danindudesilva/nbiotdevboard/Board_Bottom.jpg

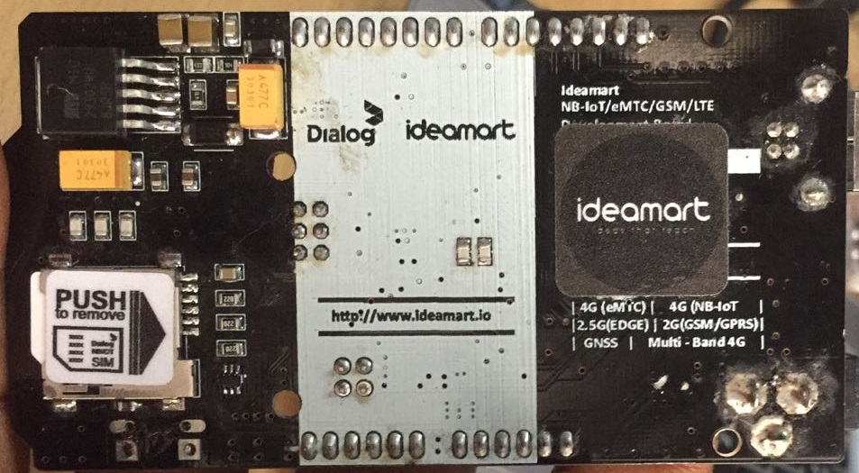
Board_Bottom.jpg
