danindudesilva/nbiotdevboard/README.md

# Ideamart NB-IoT Development Board
Schematics and PCB design files for an Arduino UNO based NB-IoT enabled connected development board
