danindudesilva/nbiotdevboard/bottom.png

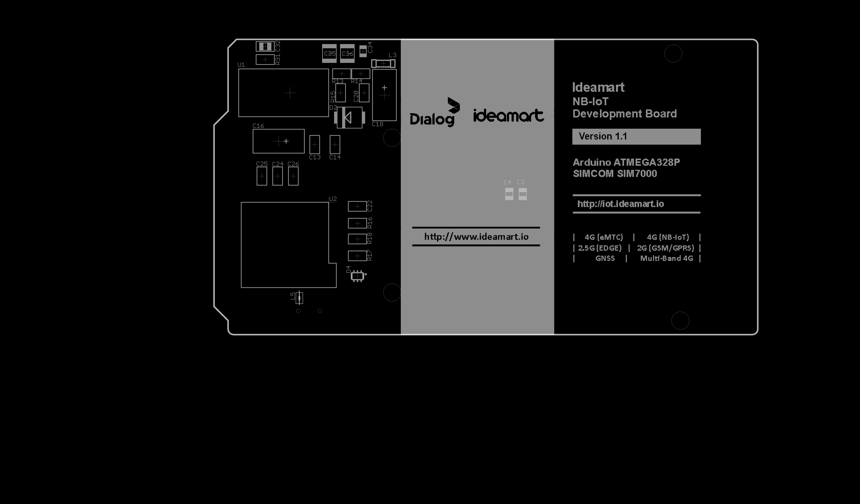
bottom.png
