danindudesilva/nbiotdevboard/top.png

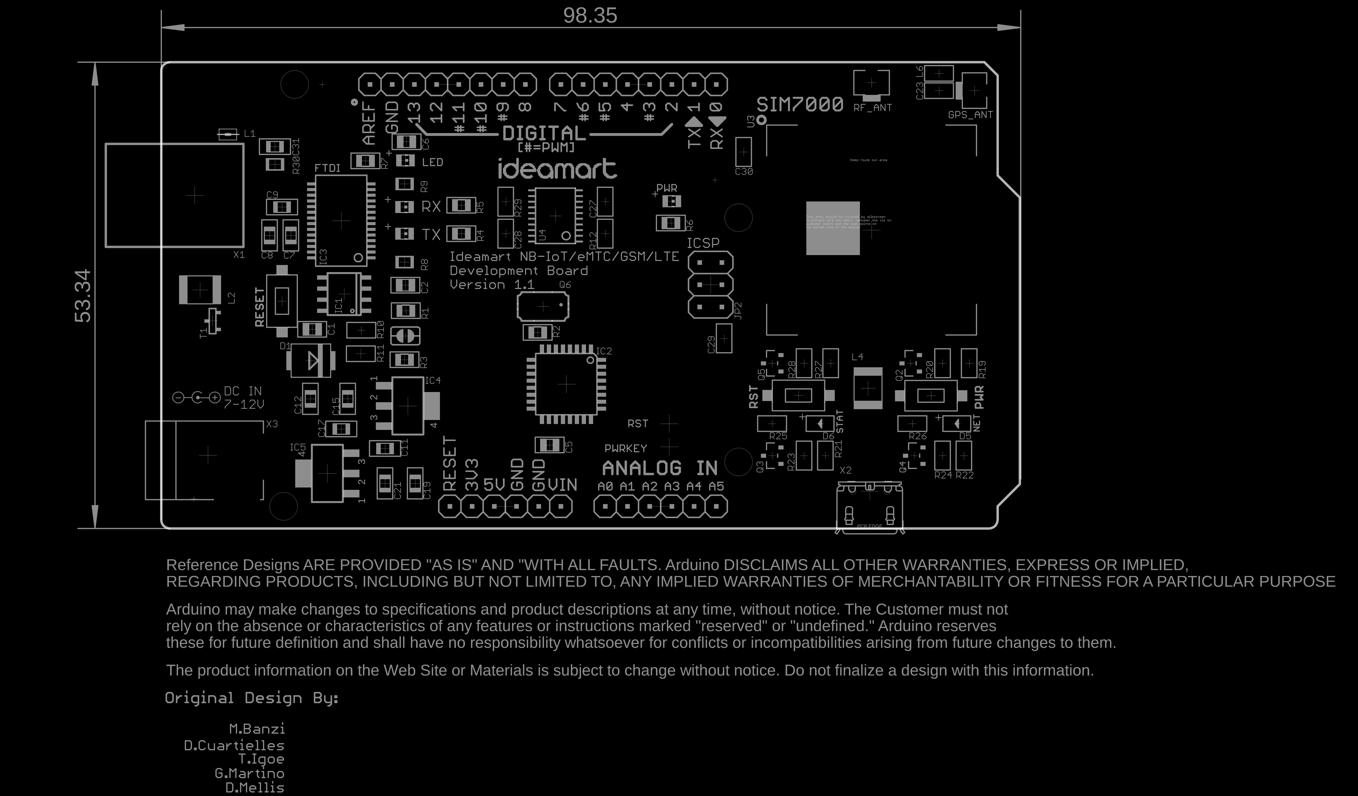
top.png
