danindudesilva/nbiotdevboard/Ideamart NB-IoT Dev Board.pdf

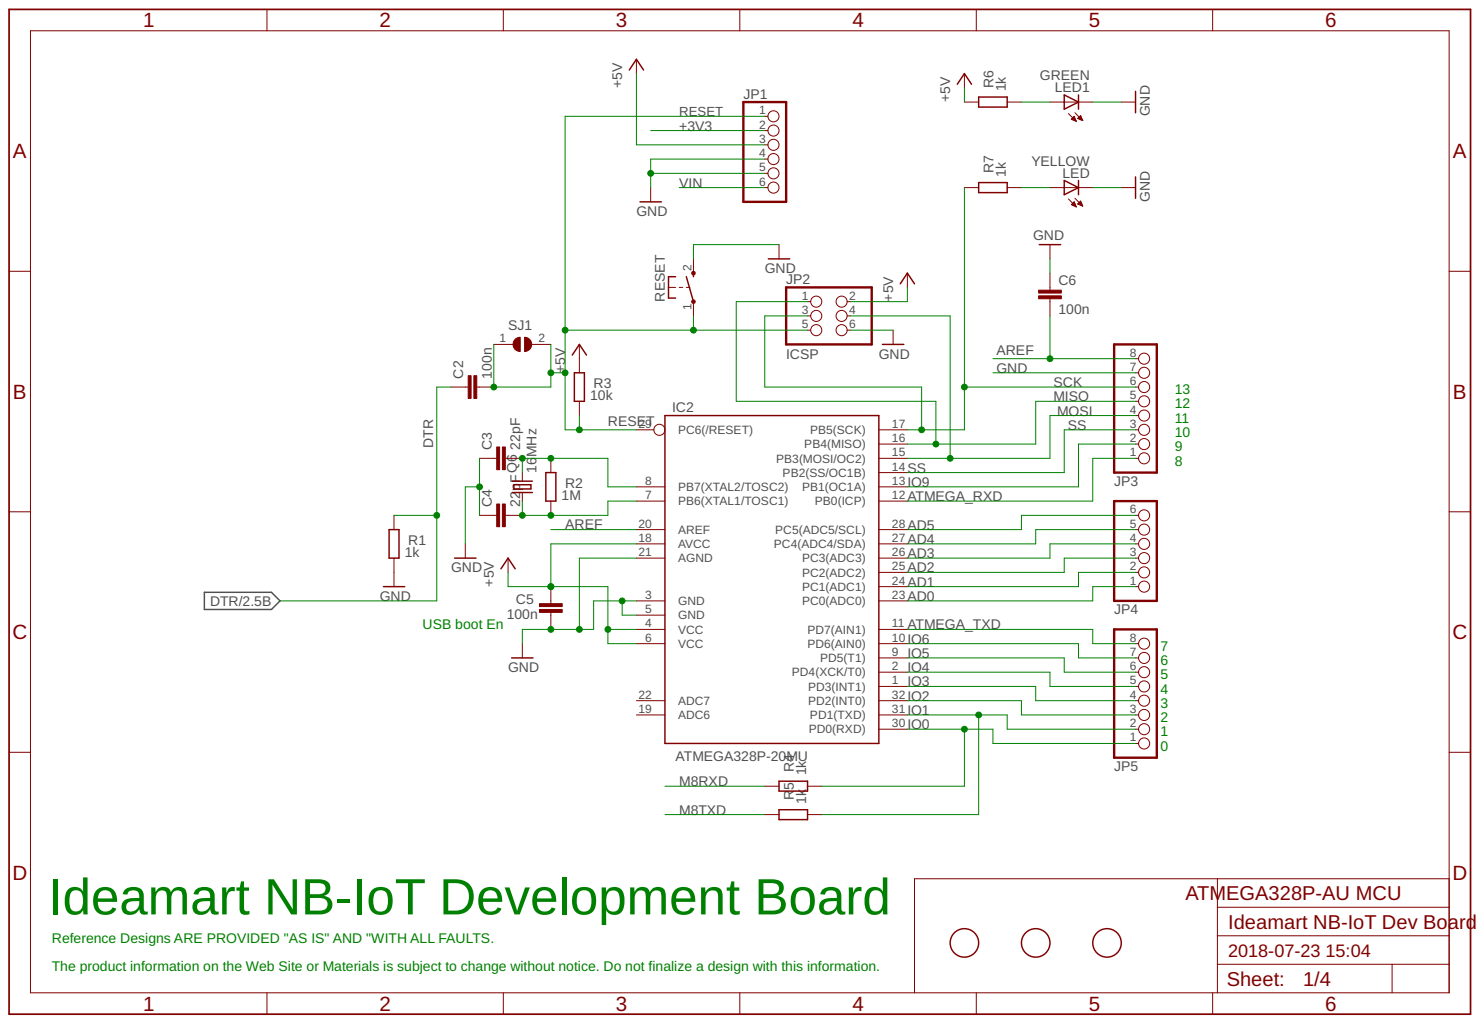
[picture p4: page 1]

IO4 | 6
IO3 | 5
IO2 | 4

Ideamart NB-IoT Development Board

ATMEGA328P-AU MCU
Ideamart NB-IoT Dev Board
Sheet: 1/4

Reference Designs ARE PROVIDED "AS IS" AND "WITH ALL FAULTS. The product information on the Web Site or Materials is subject to change without notice. Do not finalize a design with this information.

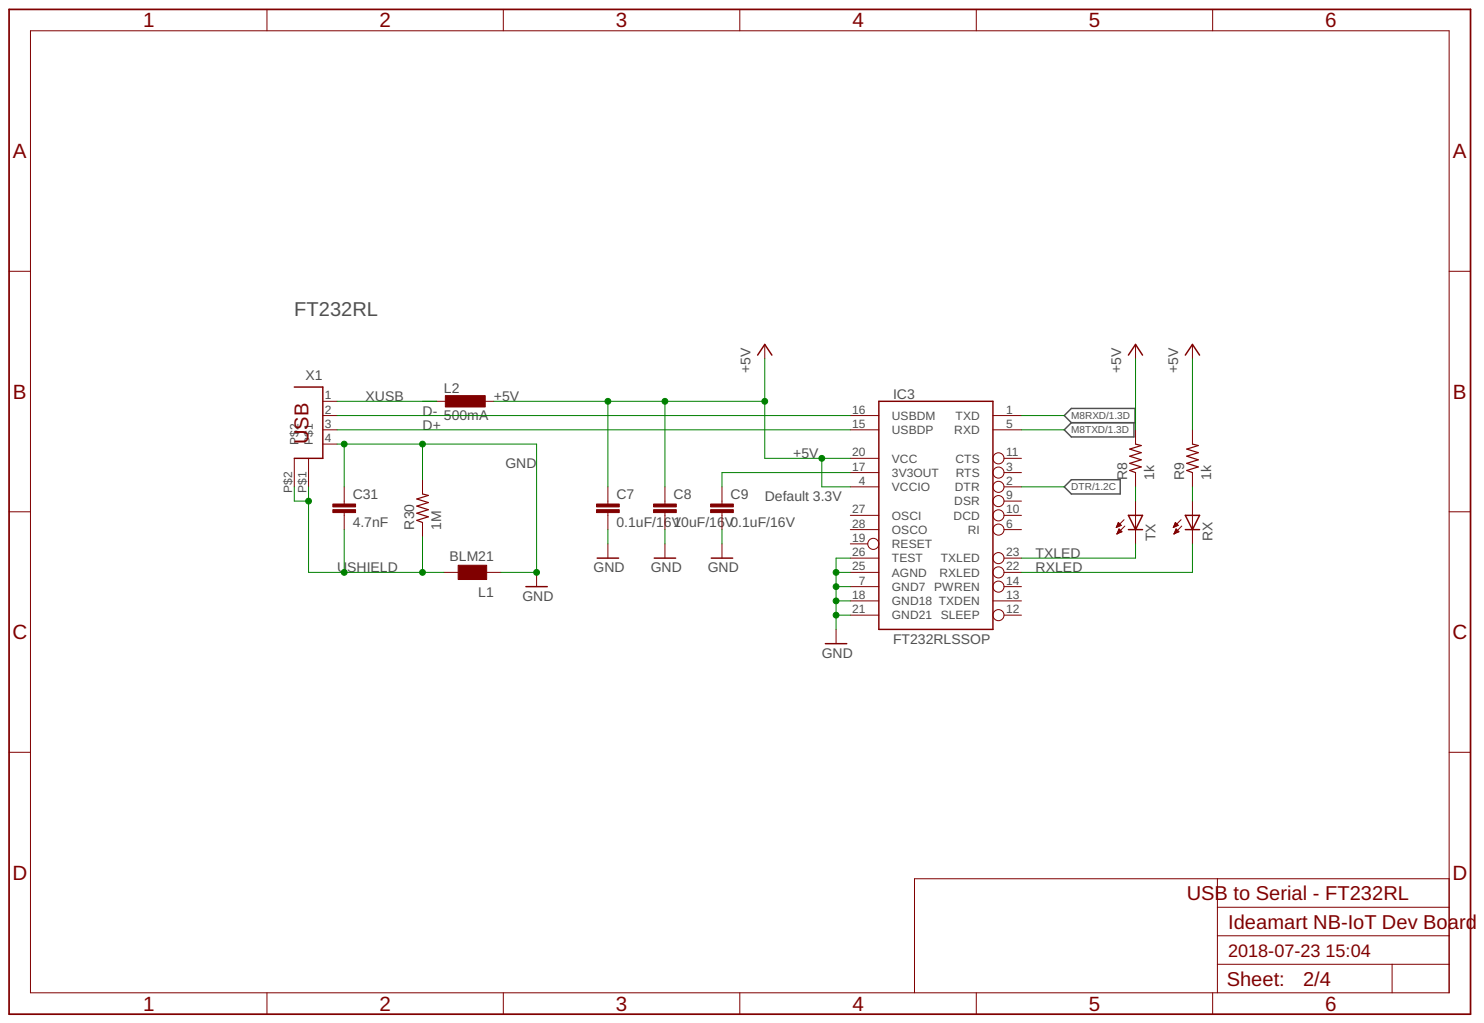
[picture p5: page 2]

USB to Serial - FT232RL
Ideamart NB-IoT Dev Board
Sheet: 2/4

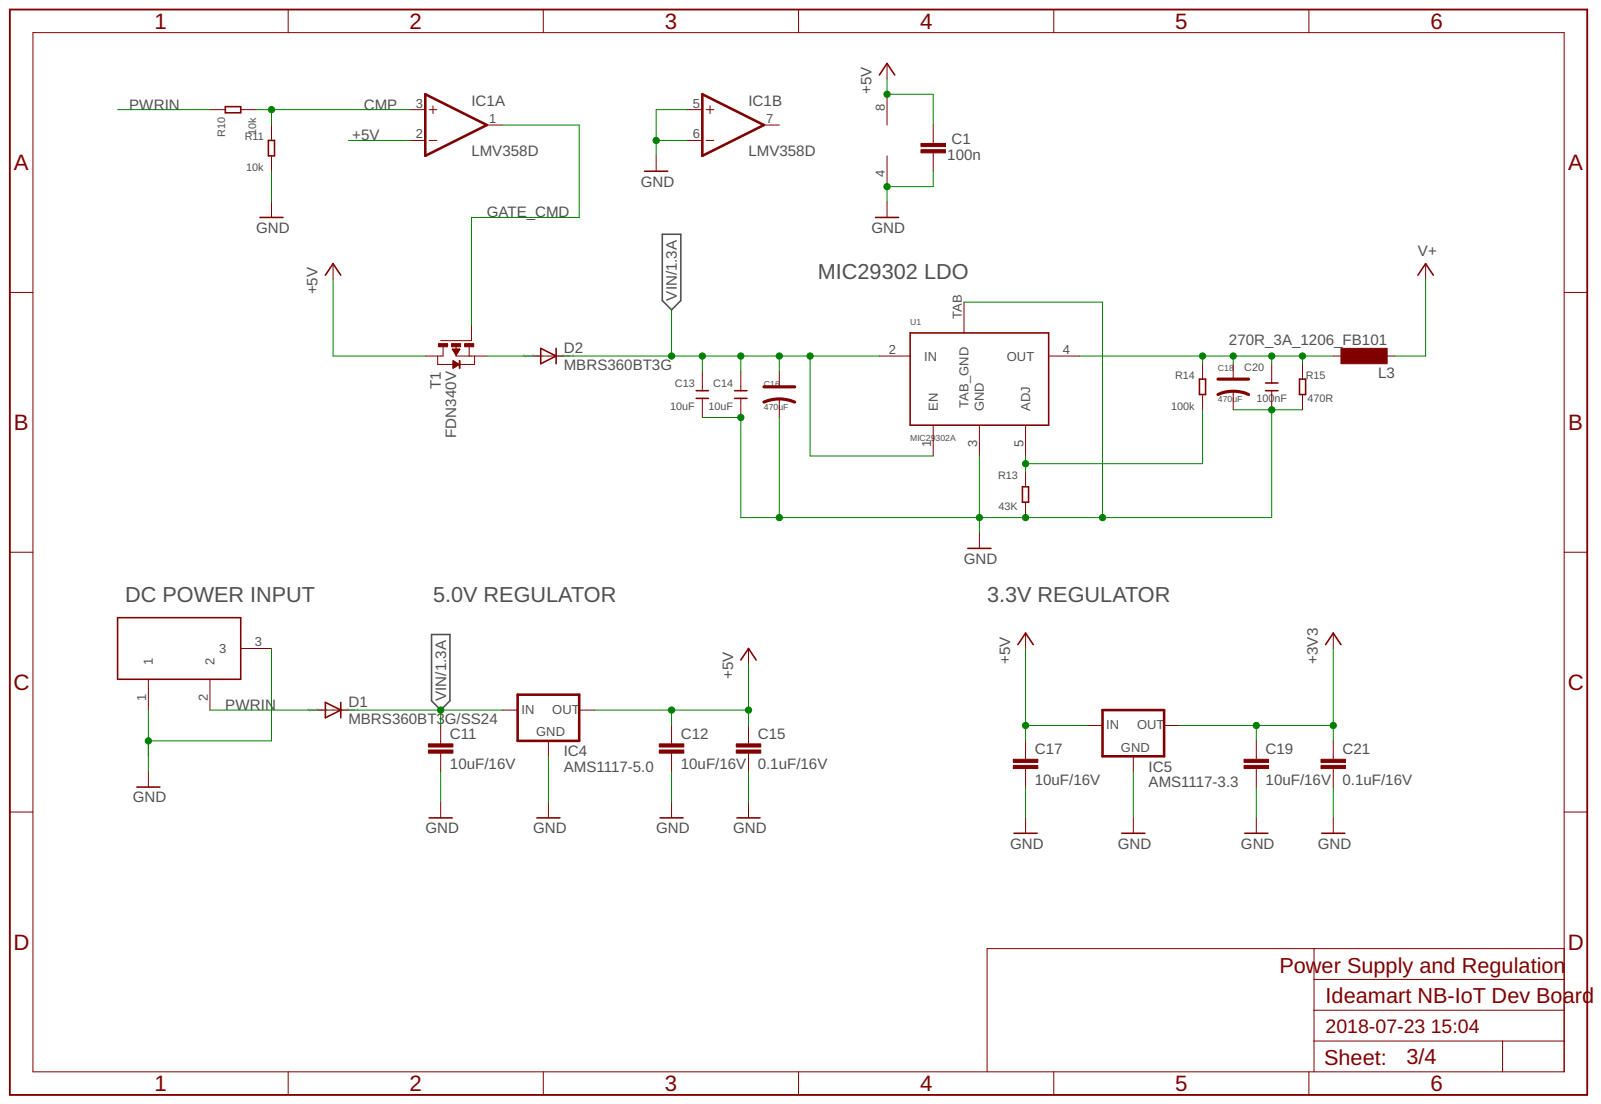
[picture p6: page 3]

Power Supply and Regulation
Ideamart NB-IoT Dev Board
Sheet: 3/4

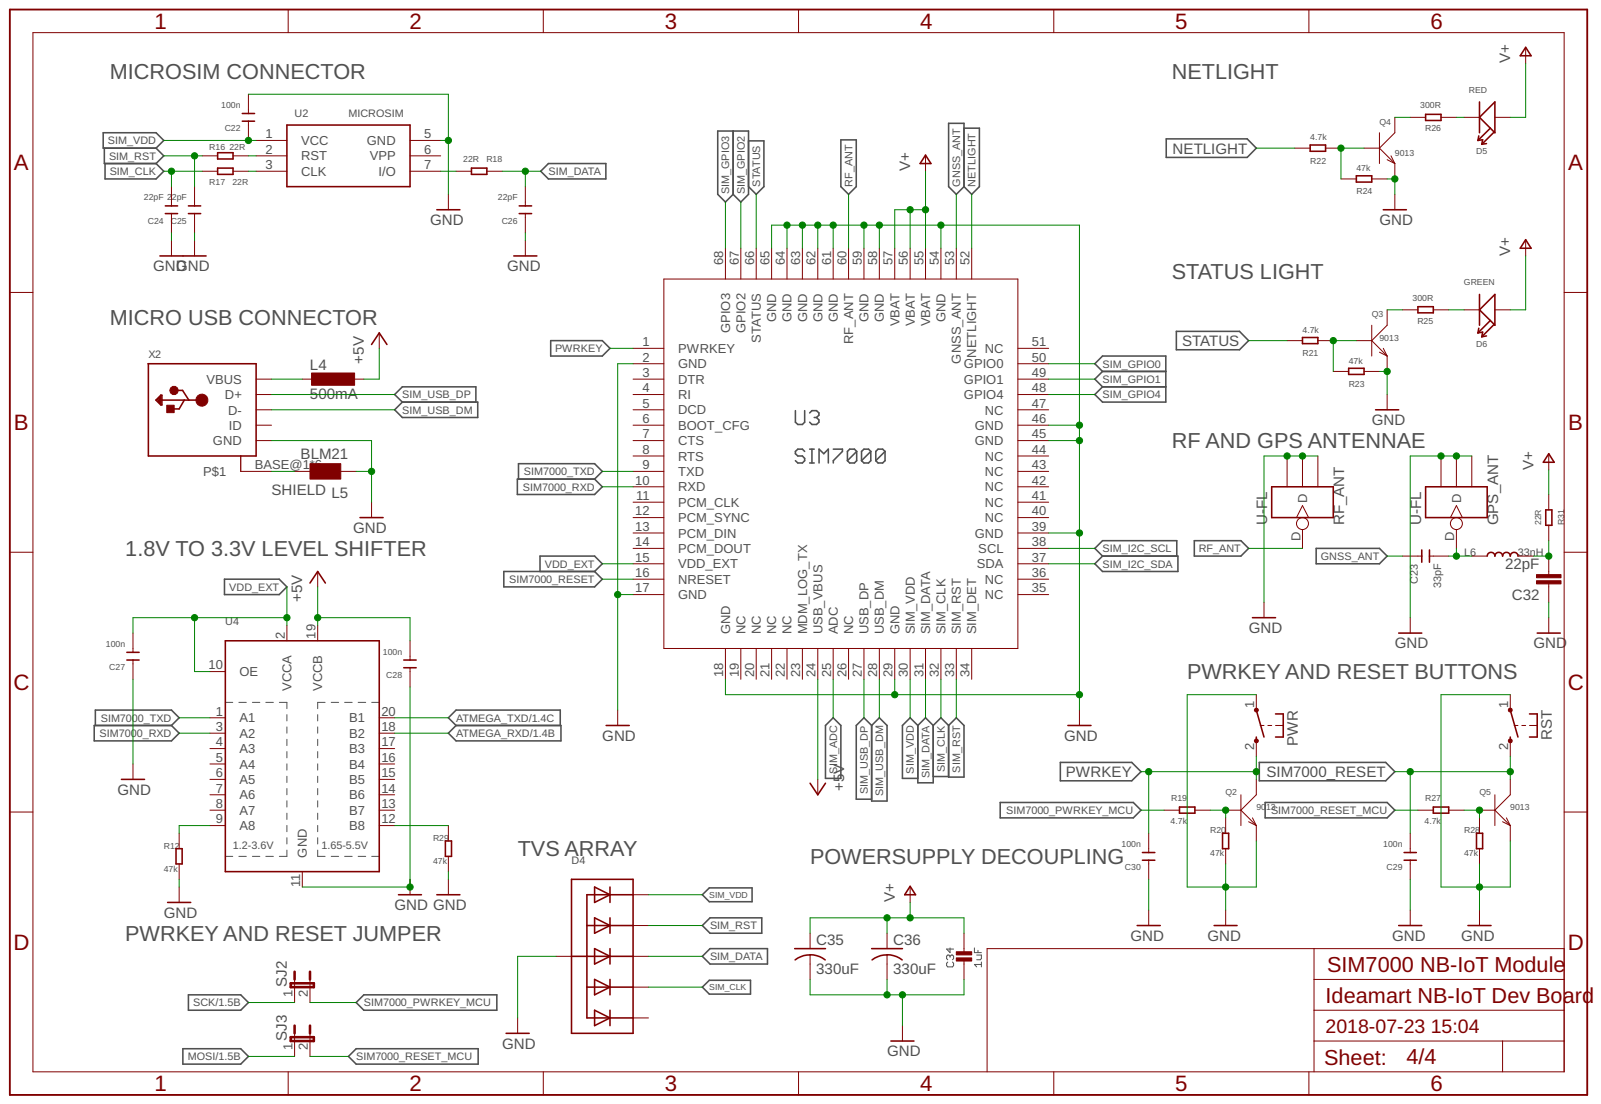
[picture p7: page 4]

RF AND GPS ANTENNAE

PWRKEY AND RESET BUTTONS

PWRKEY AND RESET JUMPER

SIM7000 NB-IoT Module
Ideamart NB-IoT Dev Board
Sheet: 4/4
