danindudesilva/nbiotdevboard/Ideamart_NB-IoT_DevBoard_v1.1.brd

## EAGLE design Ideamart_NB-IoT_DevBoard_v1.1.brd (2020-05-01)

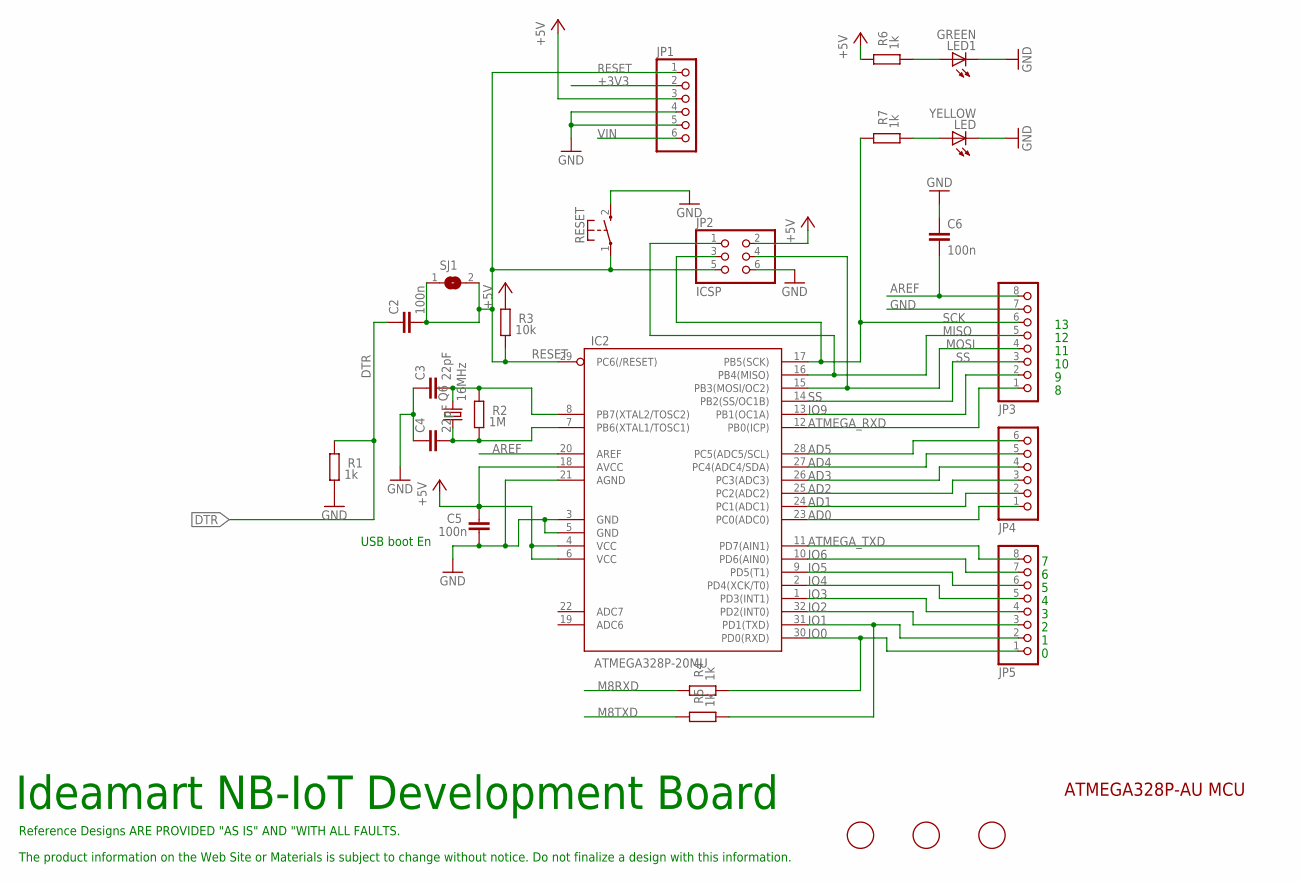
[picture p8: schematic Ideamart_NB-IoT_DevBoard_v1.1.sch, sheet 1]

Parts:
C2, C5, C6: 100n; C0805
C3, C4: 22pF; C0805
IC2: ATMEGA328P-20MU; TQFP32-08
JP1, JP4: PINHD-1X6; 1X06
JP2: ICSP; 2X03
JP3, JP5: PINHD-1X8; 1X08
LED: YELLOW; CHIP-LED0805
LED1: GREEN; CHIP-LED0805
M1, M2, M3: FIDUCIALMOUNT; FIDUCIA-MOUNT
Q6: 16MHz; CTS406
R1, R4, R5, R6, R7: 1k; R0805
R2: 1M; R0805
R3: 10k; R0805
RESET: KSS-2EG4430
SJ1: SJ

Connections:
+3V3: JP1.2; also elsewhere on the board
+5V: C5.2, IC2.4 (VCC), IC2.6 (VCC), IC2.18 (AVCC), JP1.3, JP2.2, R3.2, R6.2; also elsewhere on the board
AD0: IC2.23 (PC0(ADC0)), JP4.1
AD1: IC2.24 (PC1(ADC1)), JP4.2
AD2: IC2.25 (PC2(ADC2)), JP4.3
AD3: IC2.26 (PC3(ADC3)), JP4.4
AD4: IC2.27 (PC4(ADC4/SDA)), JP4.5
AD5: IC2.28 (PC5(ADC5/SCL)), JP4.6
AREF: C6.2, IC2.20 (AREF), JP3.8
ATMEGA_RXD: IC2.12 (PB0(ICP)), JP3.1; also elsewhere on the board
ATMEGA_TXD: IC2.11 (PD7(AIN1)), JP5.8; also elsewhere on the board
DTR: C2.1, R1.2; also elsewhere on the board
GND: C3.1, C4.1, C5.1, C6.1, IC2.3 (GND), IC2.5 (GND), IC2.21 (AGND), JP1.4, JP1.5, JP2.6, JP3.7, LED.C, LED1.C, R1.1, RESET.2 (S); also elsewhere on the board
IO0: IC2.30 (PD0(RXD)), JP5.1, R4.1
IO1: IC2.31 (PD1(TXD)), JP5.2, R5.1
IO2: IC2.32 (PD2(INT0)), JP5.3
IO3: IC2.1 (PD3(INT1)), JP5.4
IO4: IC2.2 (PD4(XCK/T0)), JP5.5
IO5: IC2.9 (PD5(T1)), JP5.6
IO6: IC2.10 (PD6(AIN0)), JP5.7
IO9: IC2.13 (PB1(OC1A)), JP3.2
M8RXD: R4.2; also elsewhere on the board
M8TXD: R5.2; also elsewhere on the board
MISO: IC2.16 (PB4(MISO)), JP2.1, JP3.5
MOSI: IC2.15 (PB3(MOSI/OC2)), JP2.4, JP3.4; also elsewhere on the board
unnamed: LED.A, R7.1
unnamed: LED1.A, R6.1
RESET: C2.2, IC2.29 (PC6(/RESET)), JP1.1, JP2.5, R3.1, RESET.1, SJ1.1, SJ1.2
SCK: IC2.17 (PB5(SCK)), JP2.3, JP3.6, R7.2; also elsewhere on the board
SS: IC2.14 (PB2(SS/OC1B)), JP3.3
VIN: JP1.6; also elsewhere on the board
XTAL1: C4.2, IC2.7 (PB6(XTAL1/TOSC1)), Q6.1, R2.1
XTAL2: C3.2, IC2.8 (PB7(XTAL2/TOSC2)), Q6.3 (2), R2.2

Notes on the sheet:
Ideamart NB-IoT Development Board
USB boot En
Reference Designs ARE PROVIDED "AS IS" AND "WITH ALL FAULTS.
The product information on the Web Site or Materials is subject to change without notice. Do not finalize a design with this information.
ATMEGA328P-AU MCU

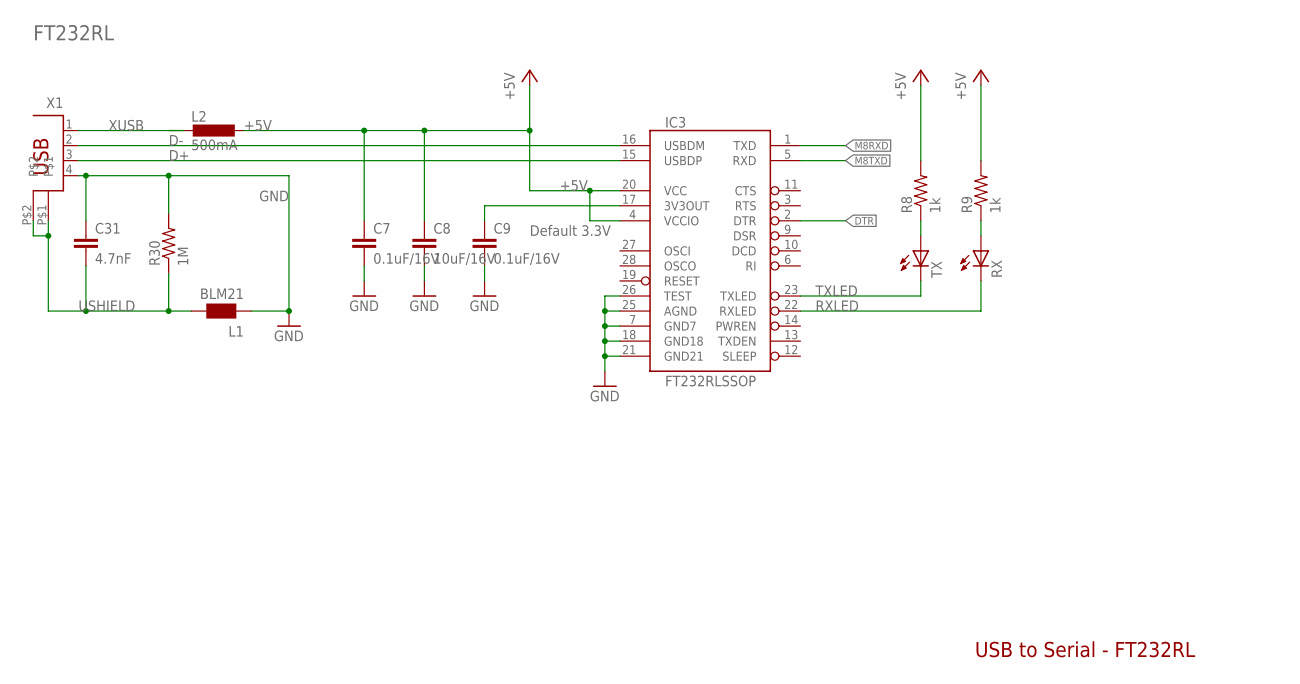
[picture p9: schematic Ideamart_NB-IoT_DevBoard_v1.1.sch, sheet 2]

Parts:
C7, C9: 0.1uF/16V; C0805K
C8: 10uF/16V; C0805K
C31: 4.7nF; C0805K
IC3: FT232RLSSOP; SSOP28DB
L1: BLM21; 0805
L2: 500mA; L1812
R8, R9: 1k; M0805
R30: 1M; M0805
RX: LEDCHIP-LED0805; CHIP-LED0805
TX: LEDCHIP-LED0805; CHIP-LED0805
X1: PN61729

Connections:
+5V: C7.1, C8.1, IC3.4 (VCCIO), IC3.20 (VCC), L2.1, R8.2, R9.2; also elsewhere on the board
D+: IC3.15 (USBDP), X1.3
D-: IC3.16 (USBDM), X1.2
DTR: IC3.2 (DTR); also elsewhere on the board
GND: C7.2, C8.2, C9.2, C31.1, IC3.7 (GND7), IC3.18 (GND18), IC3.21 (GND21), IC3.25 (AGND), IC3.26 (TEST), L1.1, R30.2, X1.4; also elsewhere on the board
M8RXD: IC3.1 (TXD); also elsewhere on the board
M8TXD: IC3.5 (RXD); also elsewhere on the board
unnamed: C9.1, IC3.17 (3V3OUT)
unnamed: R8.1, TX.A
unnamed: R9.1, RX.A
RXLED: IC3.22 (RXLED), RX.C
TXLED: IC3.23 (TXLED), TX.C
USHIELD: C31.2, L1.2, R30.1, X1.P$1, X1.P$2
XUSB: L2.2, X1.1

Notes on the sheet:
Default 3.3V
USB to Serial - FT232RL
FT232RL

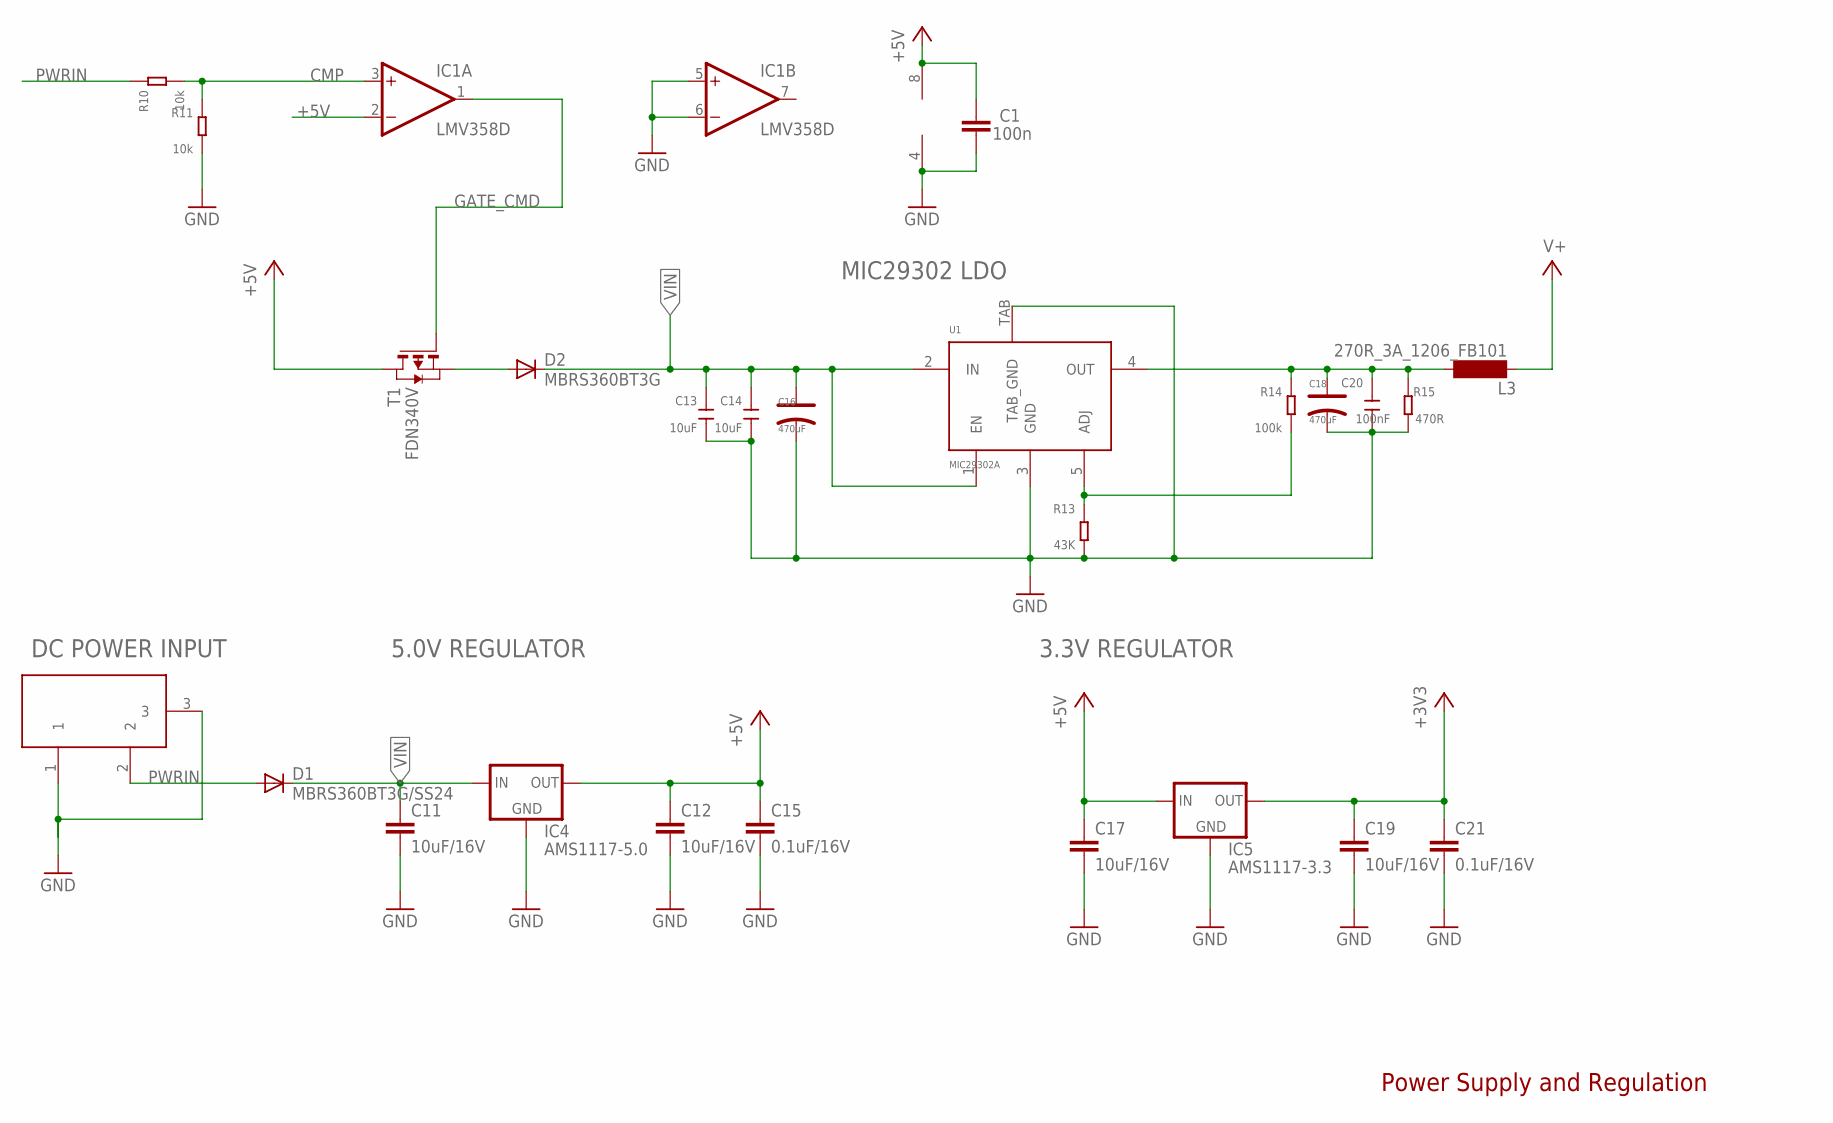
[picture p10: schematic Ideamart_NB-IoT_DevBoard_v1.1.sch, sheet 3]

Parts:
C1: 100n; C0805
C11, C12, C17, C19: 10uF/16V; C0805K
C13, C14: 10uF; 0805
C15, C21: 0.1uF/16V; C0805K
C16, C18: 470uF; AVX_D
C20: 100nF; 0805
D1: MBRS360BT3G/SS24; SMB
D2: MBRS360BT3G; SMB
IC1: LMV358D; SO08
IC4: AMS1117-5.0; SOT223
IC5: AMS1117-3.3; SOT223
L3: 270R_3A_1206_FB101; SM-1206
R10, R11: 10k; 0805
R13: 43K; 0805
R14: 100k; 0805
R15: 470R; 0805
T1: FDN340V; SOT-23
U1: MIC29302A; TO-263A
X3: DC21MMX; DC-21MM

Connections:
+3V3: C19.1, C21.1, IC5.2 (OUT); also elsewhere on the board
+5V: C1.2, C12.1, C15.1, C17.1, IC1.2 (-IN), IC1.8 (V+), IC4.2 (OUT), IC5.3 (IN), T1.1 (D); also elsewhere on the board
CMP: IC1.3 (+IN), R10.1, R11.2
GATE_CMD: IC1.1 (OUT), T1.3 (G)
GND: C1.1, C11.2, C12.2, C13.1, C14.1, C15.2, C16.-, C17.2, C18.-, C19.2, C20.1, C21.2, IC1.4 (V-), IC1.5 (+IN), IC1.6 (-IN), IC4.1 (GND), IC5.1 (GND), R11.1, R13.1, R15.1, U1.3 (GND), U1.TAB (TAB_GND), X3.1, X3.3; also elsewhere on the board
unnamed: R13.2, R14.1, U1.5 (ADJ)
unnamed: D2.A, T1.2 (S)
PWRIN: D1.A, R10.2, X3.2
V+: L3.1; also elsewhere on the board
VIN: C11.1, C13.2, C14.2, C16.+, D1.C, D2.C, IC4.3 (IN), U1.1 (EN), U1.2 (IN); also elsewhere on the board
VOUT: C18.+, C20.2, L3.2, R14.2, R15.2, U1.4 (OUT)

Notes on the sheet:
DC POWER INPUT
Power Supply and Regulation
3.3V REGULATOR
MIC29302 LDO
5.0V REGULATOR

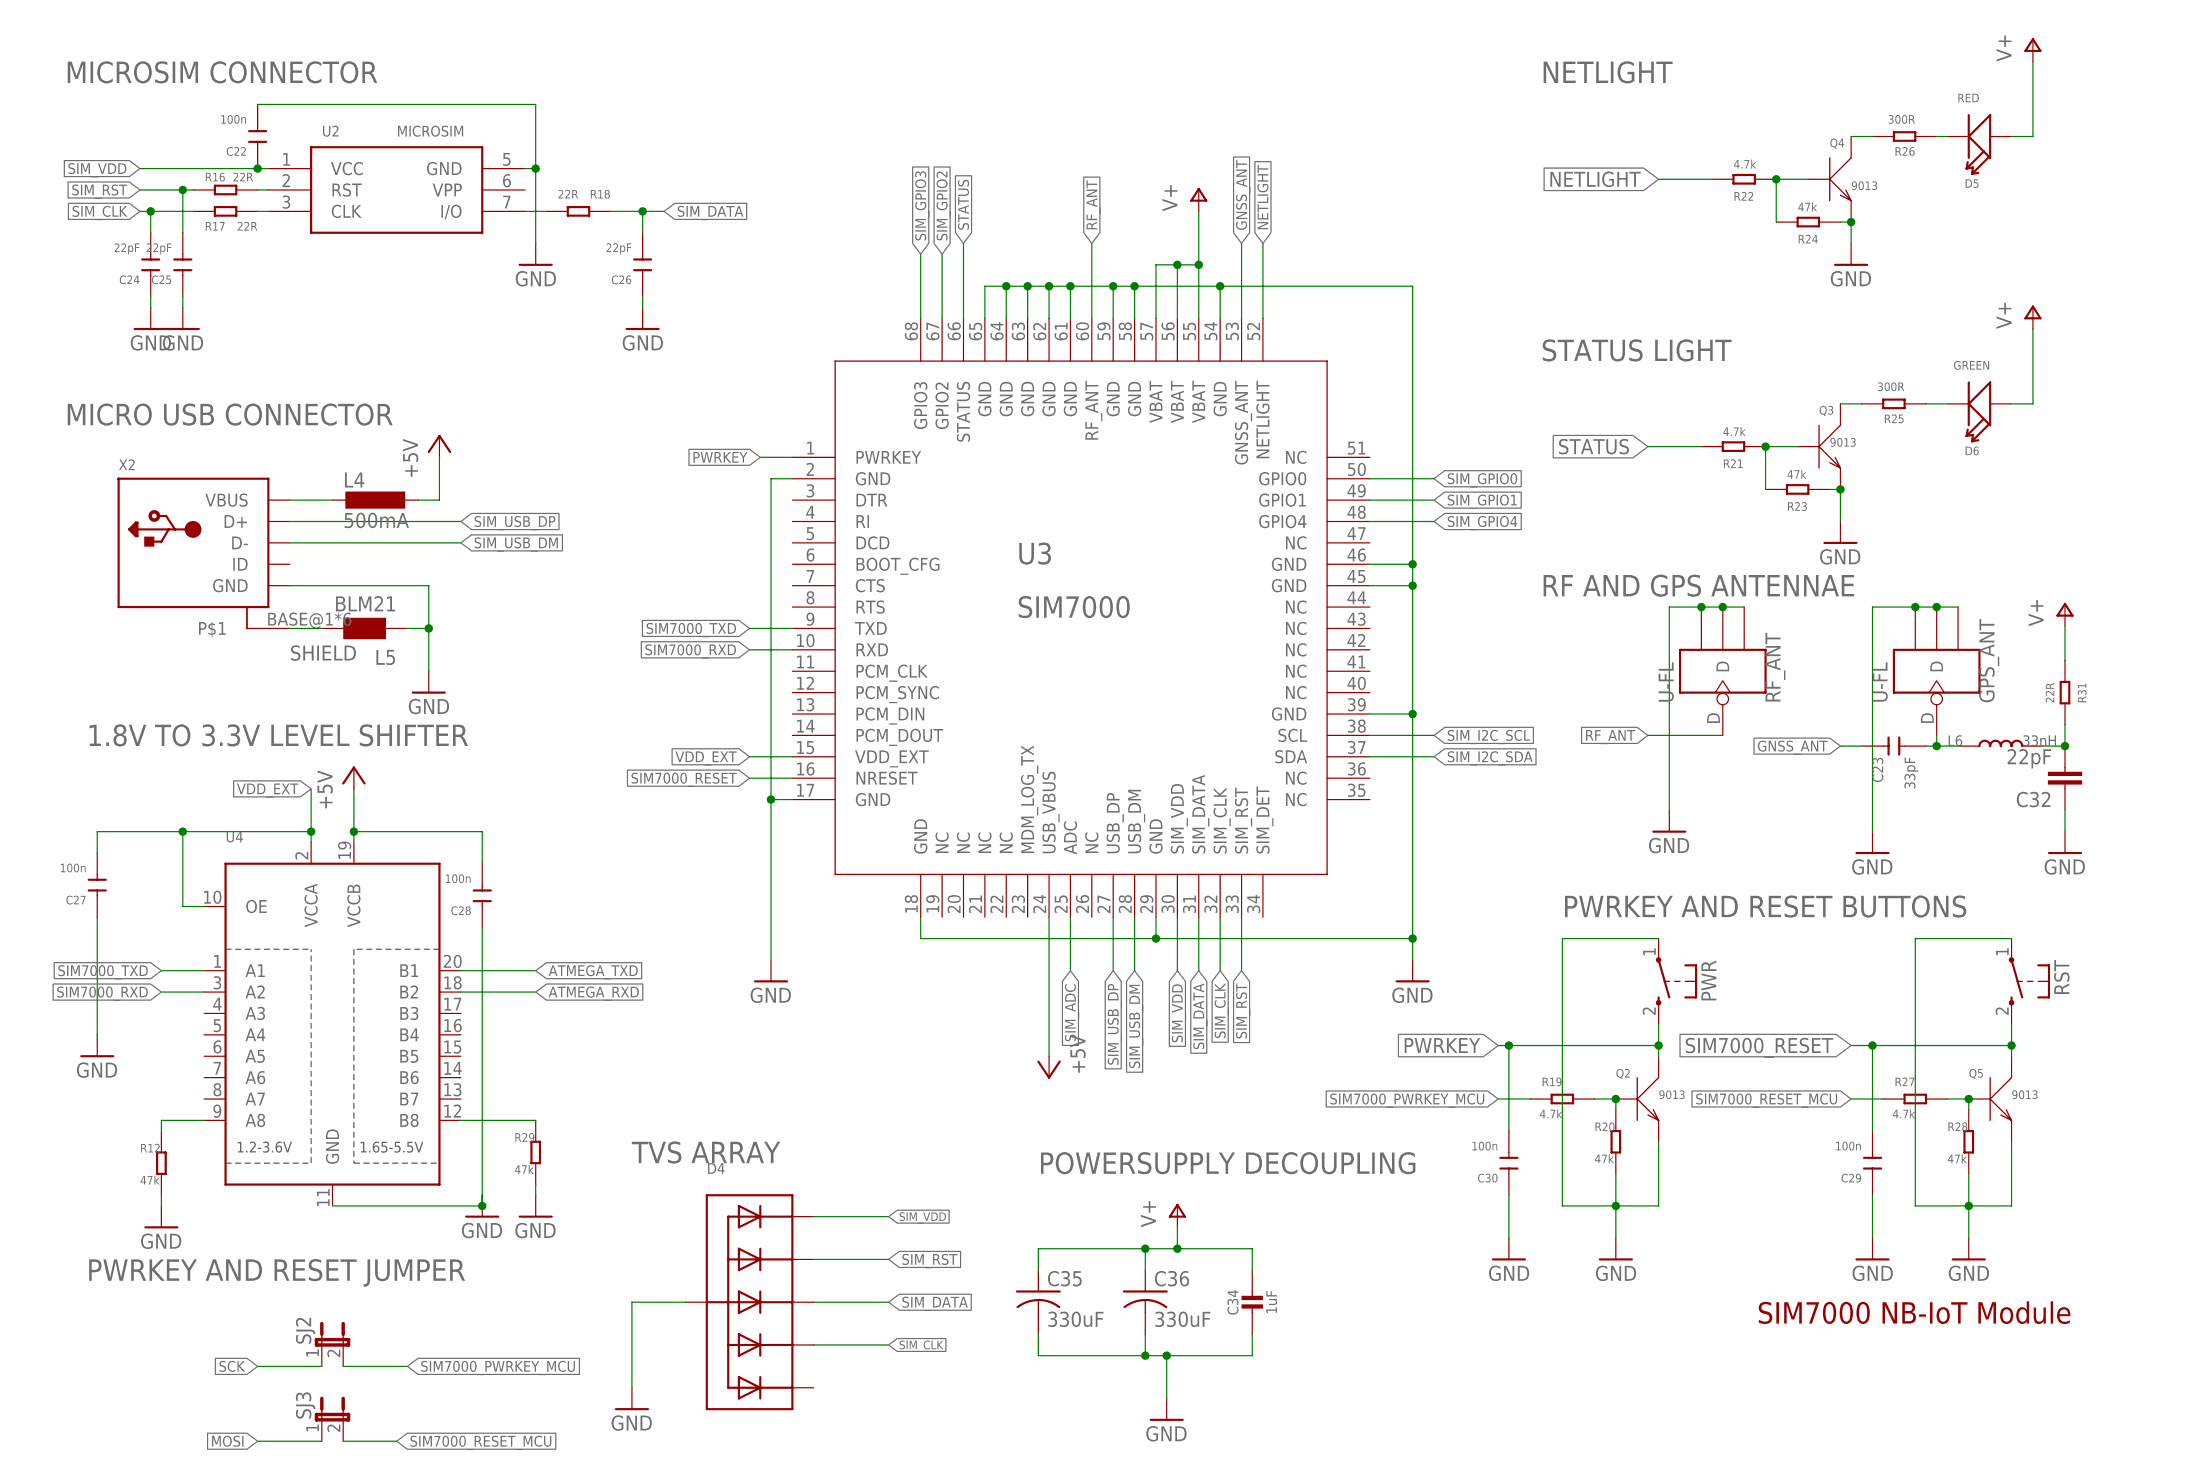
[picture p11: schematic Ideamart_NB-IoT_DevBoard_v1.1.sch, sheet 4]

Parts:
C22, C27, C28, C29, C30: 100n; 0805
C23: 33pF; 0805
C24, C25, C26: 22pF; 0805
C32: 22pF; C0805
C34: 1uF; _0805
C35, C36: 330uF; C1210
D4: TVSARRAY_5LANE; SOT363
D5: RED; LED-0805
D6: GREEN; LED-0805
GPS_ANT: U-FL; 4P-U-FL
L4: 500mA; L1812
L5: BLM21; 0805
L6: 33nH; L0805
PWR: KSS-2EG4430
Q2, Q3, Q4, Q5: 9013; SOT23
R12, R20, R23, R24, R28, R29: 47k; 0805
R16, R17, R18, R31: 22R; 0805
R19, R21, R22, R27: 4.7k; 0805
R25, R26: 300R; 0805
RF_ANT: U-FL; 4P-U-FL
RST: KSS-2EG4430
SJ2, SJ3: SPARKFUN-PASSIVES_JUMPER-PTH-2-NC; SPARKFUN-PASSIVES_PTH-JUMPER-NC_BOTTOM_NO_SILK
U2: MICROSIM
U3: SIM7000
U4: TXB0108PWR; TSSOP20
X2: USB_MICRO_20329_V2; 4UCONN_20329_V2

Connections:
+5V: C28.2, L4.1, U3.24 (USB_VBUS), U4.19 (VCCB); also elsewhere on the board
ATMEGA_RXD: U4.18 (B2); also elsewhere on the board
ATMEGA_TXD: U4.20 (B1); also elsewhere on the board
GND: C22.2, C24.1, C25.1, C26.1, C27.1, C28.1, C29.1, C30.1, C32.1, C34.2, C35.2, C36.2, D4.2 (A), GPS_ANT.GND1, GPS_ANT.GND2, GPS_ANT.GND3, L5.1, PWR.1, Q2.2 (E), Q3.2 (E), Q4.2 (E), Q5.2 (E), R12.2, R20.2, R23.2, R24.2, R28.2, R29.2, RF_ANT.GND1, RF_ANT.GND2, RF_ANT.GND3, RST.1, U2.5 (GND), U3.2 (GND), U3.17 (GND), U3.18 (GND), U3.29 (GND), U3.39 (GND), U3.45 (GND), U3.46 (GND), U3.54 (GND), U3.58 (GND), U3.59 (GND), U3.61 (GND), U3.62 (GND), U3.63 (GND), U3.64 (GND), U3.65 (GND), U4.11 (GND), X2.GND; also elsewhere on the board
GNSS_ANT: C23.2, U3.53 (GNSS_ANT)
MOSI: SJ3.1; also elsewhere on the board
unnamed: Q3.3 (C), R25.2
unnamed: D6.-, R25.1
unnamed: Q3.1 (B), R21.2, R23.1
unnamed: R18.2, U2.7 (I/O)
unnamed: R17.1, U2.3 (CLK)
unnamed: R16.1, U2.2 (RST)
unnamed: Q5.1 (B), R27.2, R28.1
unnamed: L4.2, X2.VBUS
unnamed: Q4.3 (C), R26.2
unnamed: D5.-, R26.1
unnamed: Q4.1 (B), R22.2, R24.1
unnamed: C23.1, GPS_ANT.D, L6.1
unnamed: R12.1, U4.9 (A8)
unnamed: R29.1, U4.12 (B8)
unnamed: C32.2, L6.2, R31.1
unnamed: Q2.1 (B), R19.2, R20.1
NETLIGHT: R22.1, U3.52 (NETLIGHT)
PWRKEY: C30.2, PWR.2 (S), Q2.3 (C), U3.1 (PWRKEY)
RF_ANT: RF_ANT.D, U3.60 (RF_ANT)
SCK: SJ2.1; also elsewhere on the board
SHIELD: L5.2, X2.BASE@1, X2.BASE@2, X2.SPRT@1, X2.SPRT@2, X2.SPRT@3, X2.SPRT@4
SIM7000_PWRKEY_MCU: R19.1, SJ2.2
SIM7000_RESET: C29.2, Q5.3 (C), RST.2 (S), U3.16 (NRESET)
SIM7000_RESET_MCU: R27.1, SJ3.2
SIM7000_RXD: U3.10 (RXD), U4.3 (A2)
SIM7000_TXD: U3.9 (TXD), U4.1 (A1)
SIM_ADC: U3.25 (ADC)
SIM_CLK: C24.2, D4.5 (C4), R17.2, U3.32 (SIM_CLK)
SIM_DATA: C26.2, D4.4 (C3), R18.1, U3.31 (SIM_DATA)
SIM_GPIO0: U3.50 (GPIO0)
SIM_GPIO1: U3.49 (GPIO1)
SIM_GPIO2: U3.67 (GPIO2)
SIM_GPIO3: U3.68 (GPIO3)
SIM_GPIO4: U3.48 (GPIO4)
SIM_I2C_SCL: U3.38 (SCL)
SIM_I2C_SDA: U3.37 (SDA)
SIM_RST: C25.2, D4.3 (C2), R16.2, U3.33 (SIM_RST)
SIM_USB_DM: U3.28 (USB_DM), X2.D-
SIM_USB_DP: U3.27 (USB_DP), X2.D+
SIM_VDD: C22.1, D4.1 (C1), U2.1 (VCC), U3.30 (SIM_VDD)
STATUS: R21.1, U3.66 (STATUS)
V+: C34.1, C35.1, C36.1, D5.+, D6.+, R31.2, U3.55 (VBAT), U3.56 (VBAT), U3.57 (VBAT); also elsewhere on the board
VDD_EXT: C27.2, U3.15 (VDD_EXT), U4.2 (VCCA), U4.10 (OE)

Notes on the sheet:
TVS ARRAY
MICROSIM CONNECTOR
SIM7000 NB-IoT Module
MICRO USB CONNECTOR
NETLIGHT
STATUS LIGHT
RF AND GPS ANTENNAE
PWRKEY AND RESET BUTTONS
PWRKEY AND RESET JUMPER
1.8V TO 3.3V LEVEL SHIFTER
POWERSUPPLY DECOUPLING

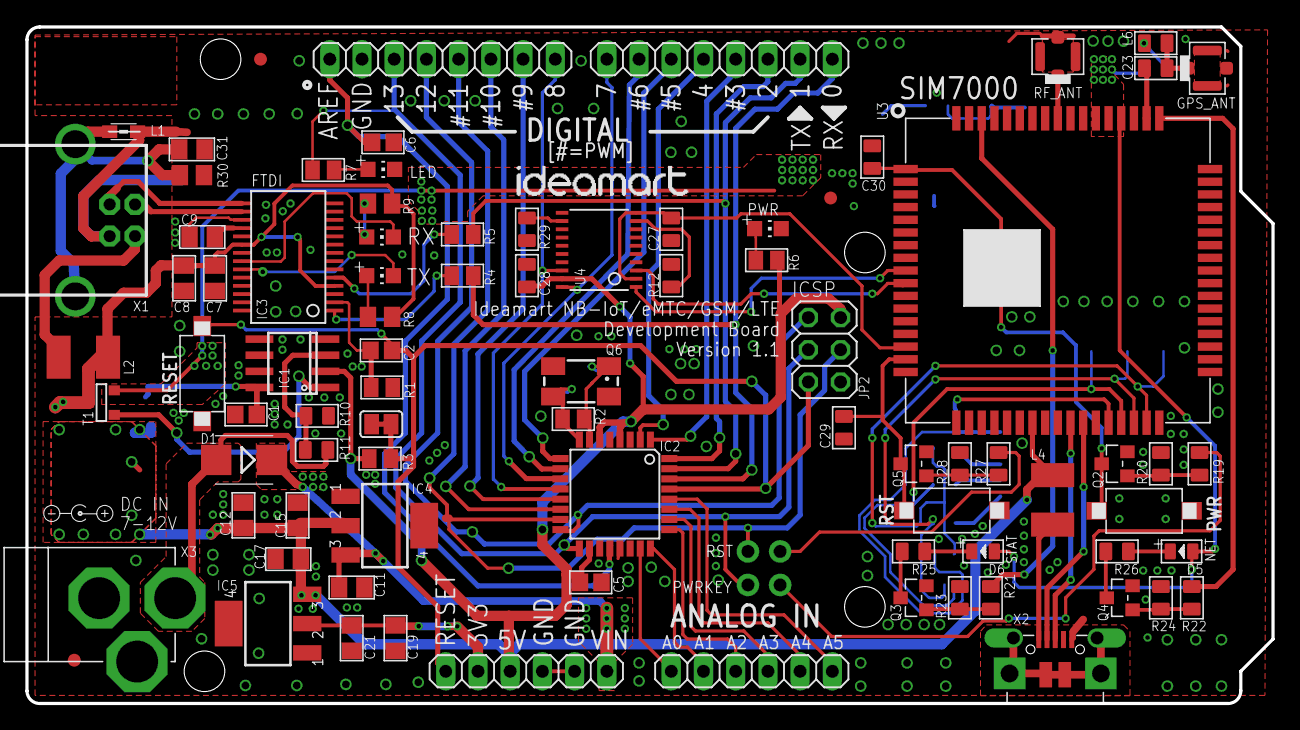
[picture p12: board Ideamart_NB-IoT_DevBoard_v1.1.brd from above]

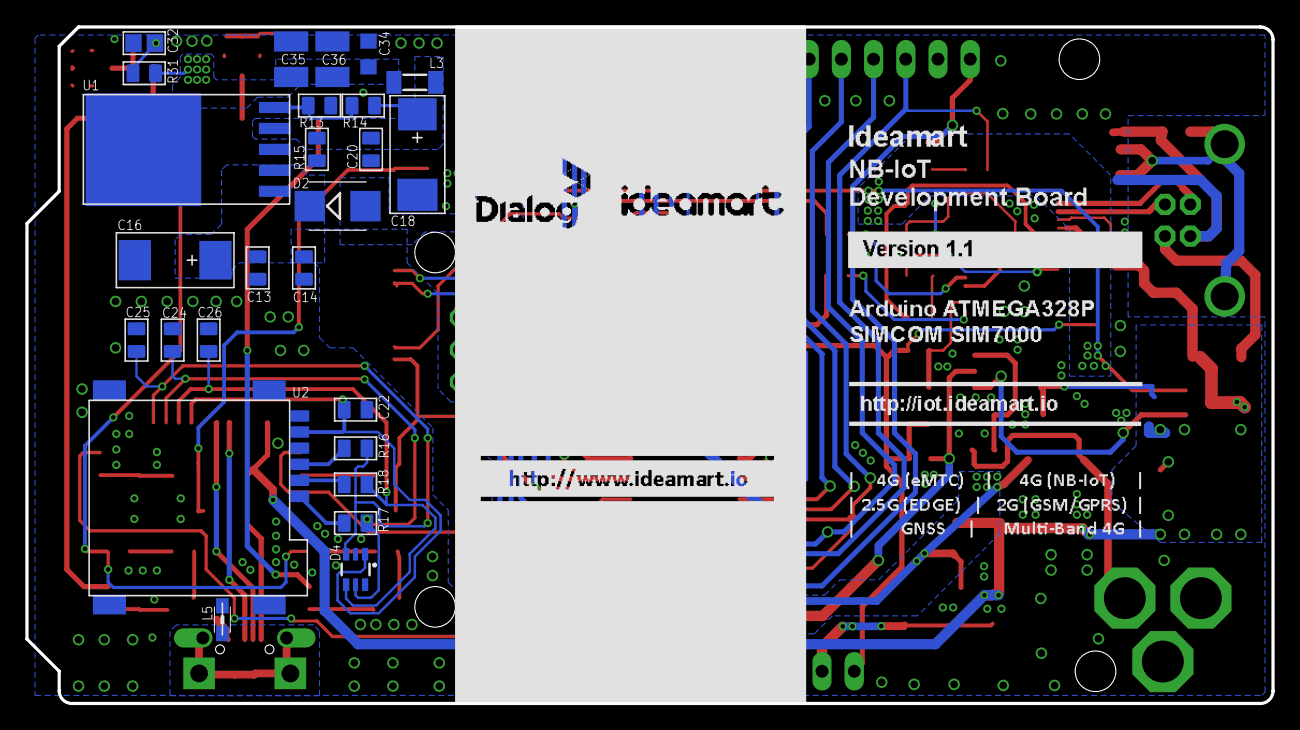
[picture p13: board Ideamart_NB-IoT_DevBoard_v1.1.brd from below]

Board: 2 copper layers, 98.2 x 53.3 mm, 114 parts (28 on the bottom side), 83 nets.
