danindudesilva/nbiotdevboard/(commit log)

2020-05-01 Initital Commit
    [Ideamart_NB-IoT_DevBoard_v1.1.brd, Ideamart_NB-IoT_DevBoard_v1.1.sch]
2020-05-01 Adds images and schematic PDFs
